epires3/ClimateControl/README.md

# ECE 388 Embedded Design Climate Control Project
## Hardware
* ATMega328p
* DHT-22 Temp Sensor
* 2x IR Sensor
* (See BOM for all board components)
## Team
* Eric Pires
* Richard Harrison
* John Lamanuzzi
