epires3/ClimateControl/Deliverables/Lab 2 Final Report.docx

Lab 2

Eric Pires

John Lamanuzzi

Richard Harrison

ECE 388

Team 3

Lab Date: September 21, 2016

Due Date: September 28, 2016

Abstract

For this laboratory assignment, various sensors and actuators were tested and evaluated for the semester project. Testing procedures were designed and executed to be able to characterize and understand them.

# Introduction

The objective of this lab was to determine design requirements of various sensors and actuators and their operations. Each component was researched to determine the pinout and specifications for suitable operation. They were then tested with unique procedures designed to observe basic functionality. The following components were utilized for this experiment:

- ATmega328p Xplained Mini board
- Hakko FX 888D
- Breadboard and Jumper Cables
- KY-033 Optical Motion Sensor
- 1602A Character LCD
- AD22100 Temperature Sensor
- KY-016 RGB LED
- SG90 Micro Servo

# Methods and Testing Procedures

## Optical Sensor

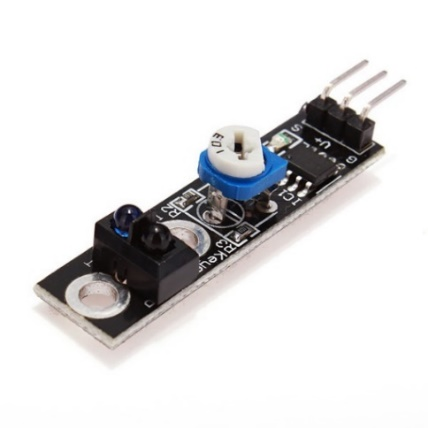
[picture p16: figure]

The optical motion sensor provided in this laboratory was the KY-033. The sensor contained 3 pins: power, ground, and output. The device was provided 5V from the microcontroller and grounded. The sensor was approached by hand to determine if it would detect motion. The sensor LED was used to indicate whether motion was present. The on-board potentiometers were adjusted to determine the length of the sensor’s detection path.

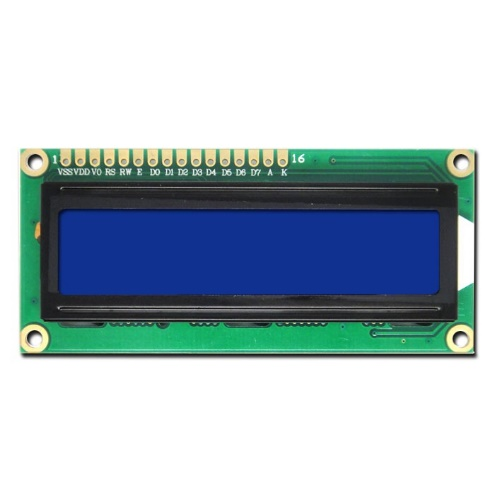
[picture p17: figure]
Image result for 1602a lcd display

## Character LCD

The 1602A LCD was provided in the laboratory. Since the component lacked breakout pins, a row of 16 male header pins was soldered onto the pads of each through-hole pin. The testing case for this device was done in conjunction with the temperature sensor. This procedure is detailed in the next section.

## Temperature Sensor

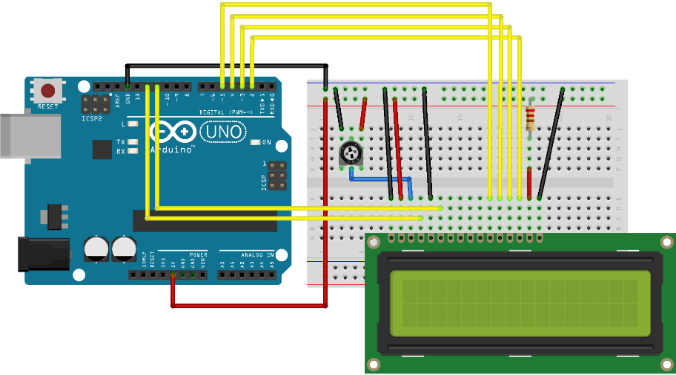
[picture p18: figure]

The temperature sensor provided in the laboratory was not used in this experiment. Instead, the AD22100 was tested. Based on the datasheet schematics, the device was powered 5V and grounded from left to right (Bottom View). To test this device, a simple program was written to calculate the measured temperature reading and output the value onto the character LCD. This was written over the provided “HelloWorld” example found under the examples folder and uploaded to the microcontroller. The following pins were connected to operate the testing procedure: (LCD pin to microcontroller pin)

- VSS to GND
- VCC to 5V
- R/W to GND
- RS to PB4
- E to PB3

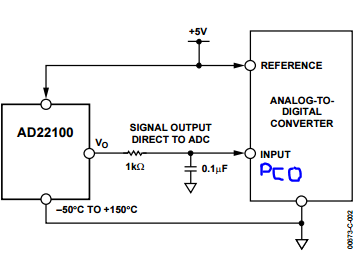
[picture p19: figure]

- D4 to PD5

Top: Arduino “HelloWorld” pinout schematic

Bot: AD22100 application schematic

- D5 to PD4
- D6 to PD3
- D7 to PD2

In addition to this detailed pinout provided by Arduino, the AD22100 was applied to the design. The application schematic for the temperature sensor can be found above. The output was then tied to PC0. The code can be found in Figure 1 of the Appendix.

## LED

The KY-016 RGB LED was provided in the laboratory. The sensor contained four pins: R, G, B, and GND. To test the device, the following color combinations were supplied with 5V and grounded to produce the expected color output:

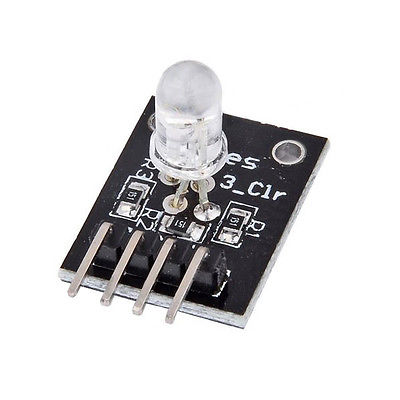
[picture p20: figure]
Image result for KY-016

- Red
- Green
- Blue
- Red and Green
- Blue and Green
- Red and Blue
- Red, Green, and Blue

## Servo

The SG90 micro servo was provided in the laboratory. The actuator contained three pins: PWM, power, and ground. To test the device, the “Sweep” example provided in the Arduino IDE was compiled and uploaded to the microcontroller. This program was designed to rotate the shaft of the servo in a bidirectional 180-degree radius. The code for this example can be found in Figure 2.

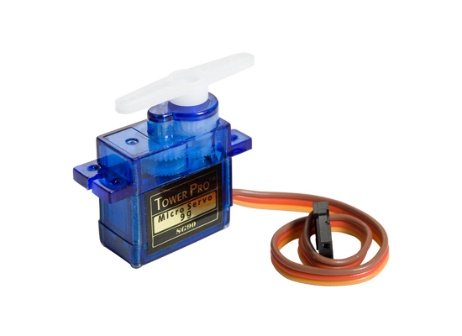
[picture p21: figure]
Image result for sg90 servo

# Results

## Motion Sensor

The motion sensor testing procedure was followed. When a hand motion was performed near the sensor’s detection path, the on-board LED was illuminated, signaling that the sensor detected the provided motion. The on-board potentiometer was adjusted to determine the range of the sensor. For this sensor, the farthest range detected was about 1-2 feet.

## Temperature Sensor and Character LCD

The temperature sensor and character LCD testing procedure was followed. The calculated temperature was measured and displayed onto the LCD. The measured temperature was 24 degrees Celsius (75.2 ° F). The air conditioning unit in the testing environment was set to about 79° F. The measured result had an error of less than 5°F when compared to the other temperature system.

## LED

The RGB LED testing procedure was followed. Different colors were created following the color combinations listed in the Procedures section. A table of the various power inputs and there recorded outputs can be found below:

Input | Output
R,GND | Red
G,GND | Green
B,GND | Blue
R,G,GND | Yellow
B,G,GND | Cyan
R,B,GND | Magenta
R,G,B,GND | White

## Servo

The servo testing procedure was followed. The specified program and servo were uploaded and connected to the microcontroller. The shaft rotated in both directions once the signal was driven by the microcontroller.

# Discussion

As this lab dealt mostly with familiarization with possible equipment for the design project, ensuring the correct operation and interfacing was the goal. That meant understanding the pinouts, input signals and outputs of each device, ensuring they all worked as designed.

The optical sensor only had one I/O pin, meaning its output would fall on one pin, making communication to the microcontroller very simple. However, since the optical sensor had its own LED that enabled when movement was detected, a simple flash of an LED was sufficient for determining the device’s response to motion.

The LCD panel contained a row of 16 pins that would generate a character given a valid output to the panel. Pins 4 (Register Select) and 6 (Enabler) enable data to pass through the device. The data bit pins (Pins 11-14) are powered to generate a given alphanumeric character. Pins 15 and 16 provided power to the LCD backlight, illuminating the crystal display for users to view the generated output. The Arduino built-in LCD library provides easy-to-use functions that initializes the display and prints data.

The temperature sensor was very rudimentary; therefore, it required the use of the LCD panel to display a valuable output. The sensor had two output pins (alongside power and ground pins), and a simple block of code interfaced it with the microcontroller. Since it changes resistance in accordance to temperature, the voltage output is measured to get a reading. This value must be converted using a formula provided in the datasheet. This calculation was simplified by using the function “celciusConvert” found in Figure 1. Initially, this sensor was connected incorrectly, producing an incredibly high temperature reading. Re-examining the datasheet revealed that the sensor was on backwards. Once this was fixed, the temperature reading seemed to provide accurate readings.

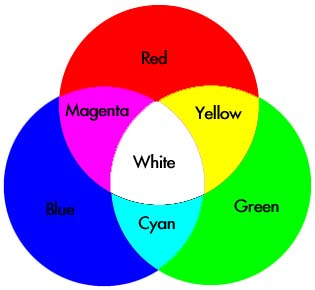
[picture p22: figure]
Image result for color mixing

For the RGB LED, the pinout and outputs were simple to understand. Each pin corresponded to a single color. Basic color mixing knowledge would dictate that red and blue makes magenta, red and green makes yellow, etc. Sending 5V to each color pin was confirmed to generate the expected color display.

The servo only contained three pins total. Interfacing with the microcontroller was simple, as only one pin was actually used for input. The Arduino tutorial for the “Sweep” example was followed to determine the device’s functionality. The servo can be viewed as controlling the blades of a fan. Such an application would direct airflow in a given environment. This application can be simplified by using a DC fan, which already contains this functionality.

# Conclusion

In conclusion, this experiment provide our group with possible procedures to implement for the prototyping stage of our design project. Working with the various sensors and actuators helped build a better understanding of how to begin working on the project. Test-driven design was the driving factor of the lab, with each step focused on the functions of each device. This helped determine how the devices (or very similar models) could be implemented in the design project.

# Reflection

This experiment provided a useful insight for our design project. Components that would be found in a climate control and room occupancy system were tested. The functionality of each device seemed easy to grasp. Using the Arduino environment simplified the testing process. The code used in this environment can be translated into C and compiled through the Atmel Studios IDE. After testing each device, we determined that a different PIR and temperature sensor should be used in our design project. The optical sensor used in this lab had a short range. The temperature sensor did not include a humidity sensor, which is another desired output for our system. Finally, the servo application can be simplified by using a DC fan, which provides similar functionality. These components will be replaced, but the same testing methods still apply for each.

# References

Fortier, Paul. (2016). Laboratory #2. Handout.

Mellis, David A., Limor Fred, and Tom Igoe. "Arduino - HelloWorld." Arduino - HelloWorld. Arduino, 17 Aug. 2015. Web. 26 Sept. 2016.

Fitzgerald, Scott. "Sweep." Arduino - Sweep. Arduino, 8 Nov. 2013. Web. 27 Sept. 2016.

# Appendix

Figure 1: LCD and Temperature Test Plan Code

/*

LiquidCrystal Library - Hello World

Demonstrates the use a 16x2 LCD display. The LiquidCrystal

library works with all LCD displays that are compatible with the

Hitachi HD44780 driver. There are many of them out there, and you

can usually tell them by the 16-pin interface.

This sketch prints "Hello World!" to the LCD

and shows the time.

The circuit:

* LCD RS pin to digital pin 12

* LCD Enable pin to digital pin 11

* LCD D4 pin to digital pin 5

* LCD D5 pin to digital pin 4

* LCD D6 pin to digital pin 3

* LCD D7 pin to digital pin 2

* LCD R/W pin to ground

* LCD VSS pin to ground

* LCD VCC pin to 5V

* 10K resistor:

* ends to +5V and ground

* wiper to LCD VO pin (pin 3)

Library originally added 18 Apr 2008

by David A. Mellis

library modified 5 Jul 2009

by Limor Fried (http://www.ladyada.net)

example added 9 Jul 2009

by Tom Igoe

modified 22 Nov 2010

by Tom Igoe

modified 23 September 2016 for temperature reading

by Eric Pires

This example code is in the public domain.

http://www.arduino.cc/en/Tutorial/LiquidCrystal

*/

// include the library code:

#include <LiquidCrystal.h>

// initialize the library with the numbers of the interface pins

//(Rs,E,4-bit data transfer)

LiquidCrystal lcd(12, 11, 5, 4, 3, 2);

int TsensorPin = A0;

double temp;

void setup() {

// set up the LCD's number of columns and rows:

lcd.begin(16, 2);

// Set sensor input to A0 (PC0)

pinMode(TsensorPin, INPUT);

// Print a message to the LCD.

lcd.print("Temp (C)");

}

void loop() {

// Calculate temperature

temp = celciusConvert(analogRead(TsensorPin));

// set the cursor to column 0, line 1

// (note: line 1 is the second row, since counting begins with 0):

lcd.setCursor(0, 1);

// Write temperature

lcd.print(temp);

// Delay sensor reading

delay(2000);

}

// Source: http://staff.mbi-berlin.de/schultz/useful_stuff/Temperature_sensors_TMP36G_and_AD22100.ino

double celciusConvert(int raw)

{

float voltage;

voltage = raw * (5000.0/1024); // Sensor value in mV:

return (voltage -1375) /22.5; // Temperature according to datasheet: 1.375 V <-> 0 Â°C

// 22.5 mV / Â°C; Ratiometric measurement, conversion valid for 5 V!

}

Figure 2: Servo “Sweep” Test Code (From Arduino Examples)

/* Sweep

by BARRAGAN <http://barraganstudio.com>

This example code is in the public domain.

modified 8 Nov 2013

by Scott Fitzgerald

http://www.arduino.cc/en/Tutorial/Sweep

*/

#include <Servo.h>

Servo myservo; // create servo object to control a servo

// twelve servo objects can be created on most boards

int pos = 0; // variable to store the servo position

void setup() {

myservo.attach(9); // attaches the servo on pin 9 to the servo object

}

void loop() {

for (pos = 0; pos <= 180; pos += 1) { // goes from 0 degrees to 180 degrees

// in steps of 1 degree

myservo.write(pos); // tell servo to go to position in variable 'pos'

delay(15); // waits 15ms for the servo to reach the position

}

for (pos = 180; pos >= 0; pos -= 1) { // goes from 180 degrees to 0 degrees

myservo.write(pos); // tell servo to go to position in variable 'pos'

delay(15); // waits 15ms for the servo to reach the position

}

}
