epires3/ClimateControl/Deliverables/BOM.xlsx

Sheet: BOM (FINAL)
Category | Value | Package | Vendor | Part Number | Board Designation | Quantity | Unit Price | Total Cost
Capacitor | 0.01uF | C0805 | Digikey | 445-6947-1-ND (http://www.digikey.com/product-detail/en/CGA4C2C0G1H103J060AA/445-6947-1-ND/2672965) | C9 | 1 | $0.32 | $0.32
LED | Green | LED0805 | Digikey | 732-4986-1-ND (http://www.digikey.com/product-detail/en/150080VS75000/732-4986-1-ND/4489922) | LED7,LED8 | 2 | $0.29 | $0.58
LED | Blue | LED0805 | Digikey | 732-4982-1-ND (http://www.digikey.com/product-detail/en/150080BS75000/732-4982-1-ND/4489910) | LED3,LED4,LED5,LED6 | 4 | $0.29 | $1.16
LED | Red | LED0805 | Digikey | 732-4984-1-ND (http://www.digikey.com/product-detail/en/150080RS75000/732-4984-1-ND/4489916) | LED1,LED2 | 2 | $0.29 | $0.58
Resistor | 22Ω | R0805 | Digikey | P22.0CCT-ND (http://www.digikey.com/product-detail/en/ERJ-6ENF22R0V/P22.0CCT-ND/1746835) | R1,R2 | 2 | $0.10 | $0.20
Test | TPTP16SQ | Test | Digikey | A106144CT-ND (http://www.digikey.com/product-detail/en/1625854-2/A106144CT-ND/3477801) | TP1-TP23 | 25 | $0.23 | $5.70
 |  |  |  |  |  | Total Cost |  | $8.54
 |  |  |  |  |  | Cost for 1 Board |  | Figure It Out
 |  |  |  | COPY OF DIGIKEY CART

Sheet: Power Board
Category | Value | Package | Vendor | Part Number | Board Designation | Board | Quantity | Unit Price | Unit Cost | Checked
Resistor | 150 | M0805 | Digikey | 311-2791-1-ND (http://www.digikey.com/product-detail/en/yageo/RT0805DRE07150RL/311-2791-1-ND/6129210) | R1,R2,R4,R5,R6 |  | 5 | $0.12 | $0.60 | yes
Resistor | 10k | M0805 | Digikey | RMCF0805JG10K0CT-ND (http://www.digikey.com/product-detail/en/stackpole-electronics-inc/RMCF0805JG10K0/RMCF0805JG10K0CT-ND/6053237) | R3,R7 |  | 2 | $0.10 | $0.20 | yes
Capacitor | 0.33uF | 805 | Digikey | 490-3327-1-ND (http://www.digikey.com/product-detail/en/murata-electronics-north-america/GRM219R71H334KA88D/490-3327-1-ND/702868) | C1 |  | 1 | $0.35 | $0.35 | yes
Capacitor | .1uF | 805 | Digikey | 478-1395-1-ND (http://www.digikey.com/product-detail/en/avx-corporation/08055C104KAT2A/478-1395-1-ND/564427) | C2,C5,C6,C7,C8,C9 |  | 6 | $0.10 | $0.60 | yes
Capacitor | 20pF | 805 | Digikey | 1276-1829-1-ND (http://www.digikey.com/product-detail/en/samsung-electro-mechanics-america-inc/CL21C200JBANNNC/1276-1829-1-ND/3889915) | C3,C4 |  | 2 | $0.10 | $0.20 | yes
Crystal | 16MHz | HC49UP | Digikey | XC1793CT-ND (http://www.digikey.com/product-detail/en/ecs-inc/ECS-160-20-3X-EN-TR/XC1793CT-ND/2676657) | Cryst |  | 1 | $0.44 | $0.44 | yes
Diode | N/A | DO-214AC | Digikey | MRA4007T3GOSCT-ND (http://www.digikey.com/product-detail/en/on-semiconductor/MRA4007T3G/MRA4007T3GOSCT-ND/964566) | D1,D2 |  | 2 | $0.30 | $0.60 | yes
Temp/Hum Sensor | N/A | N/A | Digikey | SEN-10167-ND (http://www.digikey.com/product-detail/en/sparkfun-electronics/SEN-10167/SEN-10167-ND/6163749) | DHT-22 |  | 1 | $9.95 | $9.95 | yes
Voltage Regulator | 5V Out | TO252 | Digikey | MC78M05CDTRKG (http://www.digikey.com/product-detail/en/on-semiconductor/MC78M05CDTRKG/MC78M05CDTRKGOSCT-ND/1139757) | IC1 |  | 1 | $0.44 | $0.44 | yes
Relay Socket | N/A | DO-214AC | Digikey | MRA4007T3GOSCT-ND (http://www.digikey.com/product-detail/en/on-semiconductor/MRA4007T3G/MRA4007T3GOSCT-ND/964566) | K1,K2 |  | 2 | $0.30 | $0.60 | yes
Relay | 5V Coil | SPDT TH | Digikey | PB2032-ND (http://www.digikey.com/product-detail/en/te-connectivity-potter-brumfield-relays/ORWH-SH-105D1F,000/PB2032-ND/4925028) | RLY-1,RLY-2 |  | 2 | $1.39 | $2.78 | yes
LED | Red | SML0805 | Digikey | 475-1415-1-ND (http://www.digikey.com/product-detail/en/osram-opto-semiconductors-inc/LH-R974-LP-1/475-1415-1-ND/1802604) | LED1,LED2,MAX |  | 3 | $0.26 | $0.78 | yes
LED | Green | SML0805 | Digikey | 475-1410-1-ND (http://www.digikey.com/product-detail/en/osram-opto-semiconductors-inc/LG-R971-KN-1/475-1410-1-ND/1802598) | POWER |  | 1 | $0.26 | $0.26 | yes
BJT | NPN | SOT23 | Digikey | MMBT3904FSCT-ND (http://www.digikey.com/product-detail/en/fairchild-semiconductor/MMBT3904/MMBT3904FSCT-ND/458971) | Q1,Q2 |  | 2 | $0.16 | $0.32
MOSFET | N-Channel | SOT23 | Digikey | 568-6215-1-ND (http://www.digikey.com/product-detail/en/nxp-semiconductors/BSH105,215/568-6215-1-ND/2531502) | Q3 |  | 1 | $0.36 | $0.36
Microcontroller | ATMega328P | TQFP32-08 | Digikey | ATMEGA328P-AURCT-ND (http://www.digikey.com/product-detail/en/atmel/ATMEGA328P-AUR/ATMEGA328P-AURCT-ND/3789455) | U1 |  | 1 | $3.81 | $3.81
Barrel Jack | Male | PJ-102A | Digikey | CP-102A-ND (http://www.digikey.com/product-detail/en/cui-inc/PJ-102A/CP-102A-ND/275425) | DC_JCK |  | 1 | $1.00 | $1.00
Screw Terminal | 2-pin | 1751248 | Digikey | A98159-ND (http://www.digikey.com/product-detail/en/te-connectivity-amp-connectors/284391-2/A98159-ND/1827021) | FAN |  | 1 | $0.97 | $0.97
Screw Terminal | 3-pin | W237-103 | Digikey | A114514-ND (http://www.digikey.com/product-detail/en/te-connectivity-amp-connectors/796681-3/A114514-ND/1153980) | Terminal |  | 2 | $1.87 | $3.74
Header | 1*3-pin | Male | Digikey | 952-1312-ND (http://www.digikey.com/product-detail/en/harwin-inc/M22-2510305/952-1312-ND/2264293) | PIR-IN,PIR-OUT |  | 2 | $0.23 | $0.46
Header | 2*3-pin | Male | Digikey | 609-3234-ND (http://www.digikey.com/product-detail/en/amphenol-fci/67997-206HLF/609-3234-ND/1878491) | ISP |  | 1 | $0.31 | $0.31
Header | 2*6-pin | Male | Digikey | 609-5137-ND (http://www.digikey.com/product-detail/en/amphenol-fci/77313-818-12LF/609-5137-ND/4275795) | LCD |  | 1 | $0.80 | $0.80
Tactile Switch | N/A | EVQ-Q2 | Digikey | 450-1129-ND (http://www.digikey.com/product-detail/en/te-connectivity-alcoswitch-switches/FSM4JSMATR/450-1759-1-ND/2271638) | UP,DOWN,RESET |  | 3 | $0.28 | $0.84
Ribbon Cables | N/A | F/F | Digikey | 1528-1379-ND (http://www.digikey.com/product-detail/en/adafruit-industries-llc/266/1528-1379-ND/5629427) | N/A |  | 1 | $3.95 | $3.95
Power Cable | 12V, 1A | N/A | Digikey | 237-1455-ND (http://www.digikey.com/product-detail/en/triad-magnetics/WSU120-1000/237-1455-ND/3094981) | N/A |  | 1 | $8.93 | $8.93
 |  |  |  |  |  |  |  | Total | $43.29
