epires3/ClimateControl/(commit log)

2016-09-25 Temp Sensor, Fans & LEDs
2016-10-11 Prototype Code and Procedures
2016-10-31 PCB Rev 1
    Traces for relay need adjustments, button breakout board still required
    [388_Project.brd, 388_Project.sch]
